ncsurobotics/DEPRECATED-SW8-Electrical/README.md

# Seawolf 8 Project Repository
This repo contains the design files and other relevant information about the load balancing board for SW8.
