ncsurobotics/DEPRECATED-SW8-Electrical/projects/meb/MEB.pdf

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
ENABLE

KILL_3V3

SCL

SDA

MSP430
Microcontroller.SchDoc

GND

+3.3V

SSR_IN
ENABLE

Designator
Power Control.SchDoc

GATE
KILL_RAW

KILL_3V3

Designator
ThrusterControl.SchDoc

1
2
3
4

P12

22-27-2041

Drain
Gate
Source

P11

22-27-2031

GND

D11

1N4007-T

VCC

2
1

P13

22-27-2021

R11
4.7k

GND

Killswitch external input

3

2 1

4

6 5

8 7 10 9
P14
HTSS-105-01-T-DV

GND

5V Power Bank for fans, etc

External connection to IXTN660N04T4

VCC FLYBACK
GATE

KILL_RAW

+5V

SDA
SCL

I2C Header

2
1

P15

22-27-2021

SSR_IN

Relay Coil Input

BATT

Designator
PowerConditioning.SchDoc

2

1

P16

B2B-XH-A(LF)(SN)

BATT

GND

D D

C C

B B

A A

Title

Size | Number | | Revision
A
Date: | 9/22/2019 | Sheet | of
File: | C:\Users\..\Microcontroller.SchDoc | Drawn By:

P1.4
P1.3

P1.5

P1.7

P1.6

RST

NC

P3.0

P1.2

GND

P22

61301011121

P4.2

Vcc

P2.6
P2.5
P4.3
P2.4
P2.2
P3.4
P3.5
P3.6

P21

61301011121

+3.3V | GND

VCC

GND

R21
8.2k

R22
2k
V_SENSE | KILL_3V³
KILL_3V3 | ENABLE

+3.3V

R23
4.7k
R24

4.7k SCL SDA

SDA
SCL

D D

C C

B B

A A

Title

Size | Number | Revision
File: | C:\Users\..\Power Control.SchDoc | Drawn By:

PMV16XNR

# Q31 SSR_IN

GND | 1

2

3

4

FSM2JSMA

SW31

GND

R32
1k

R33

# 100 ENABLE

1

2

3

4

FSM2JSMA

SW32

GND

SSR_ENABLE

GND

3
2
1

P31

22-27-2031

SSR_IN

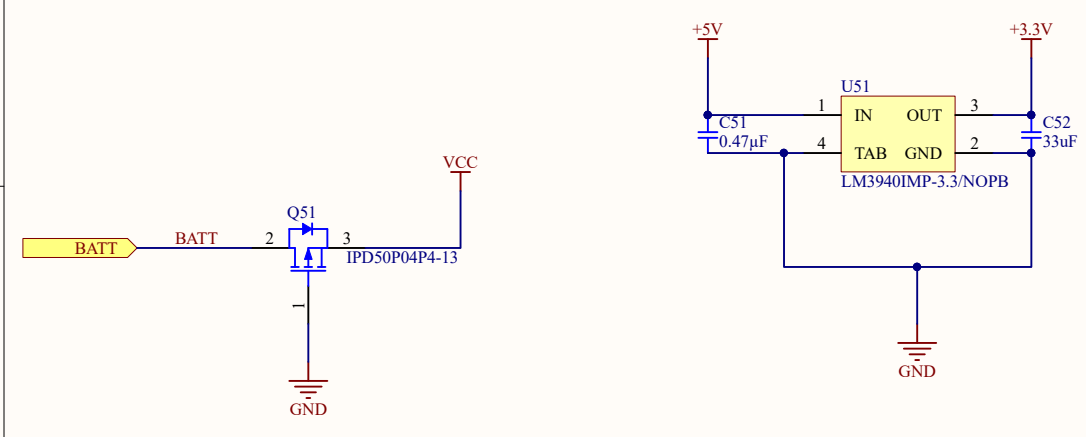
[picture p1: page 4]
Title; Size; Number; Revision; File:; C:\Users\..\PowerConditioning.SchDoc; Drawn By:; VCC; IPD50P04P4-13; GND; BATT; OUT; 2 TAB 4; LM3940IMP-3.3/NOPB

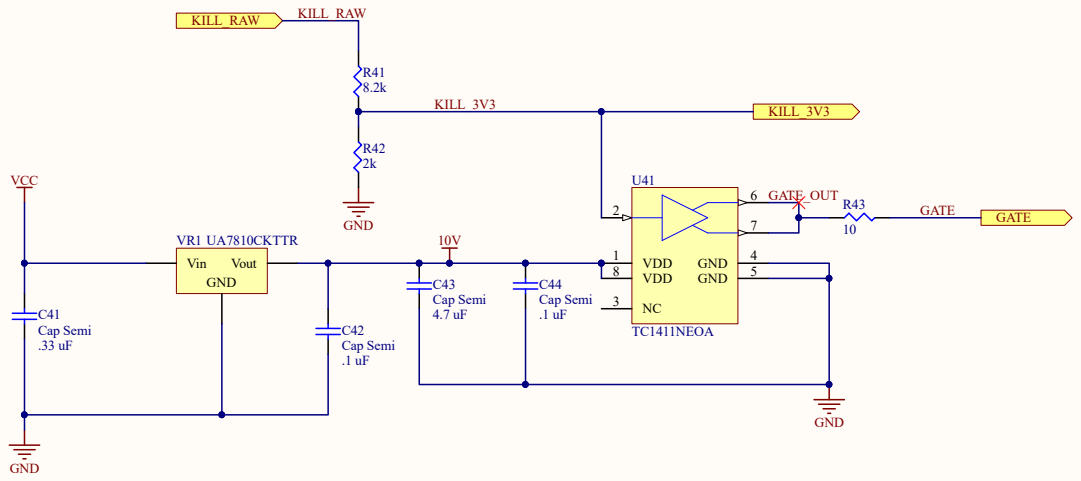
[picture p2: page 5]
