ncsurobotics/DEPRECATED-SW8-Electrical/projects/new_member_Altium_project/Project Outputs for New Member Design Project/New Member Design Project.pdf

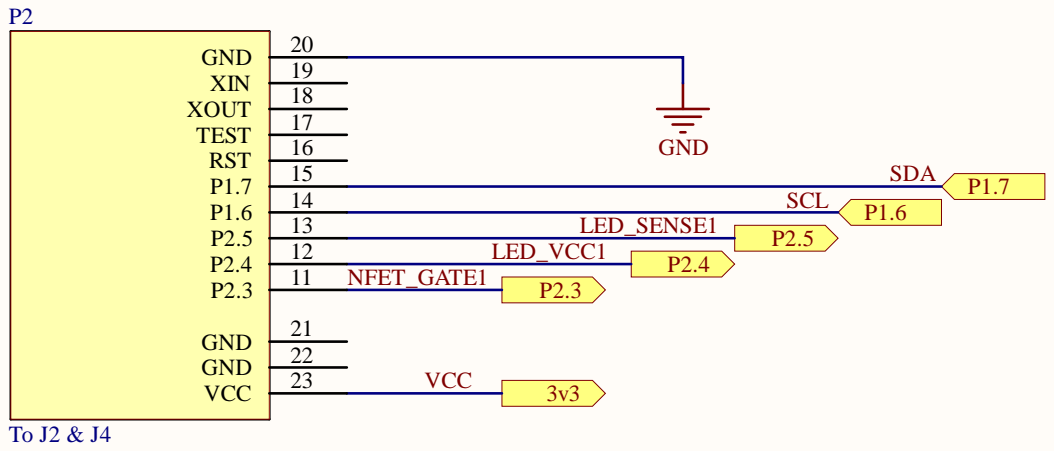
[picture p3: page 1]

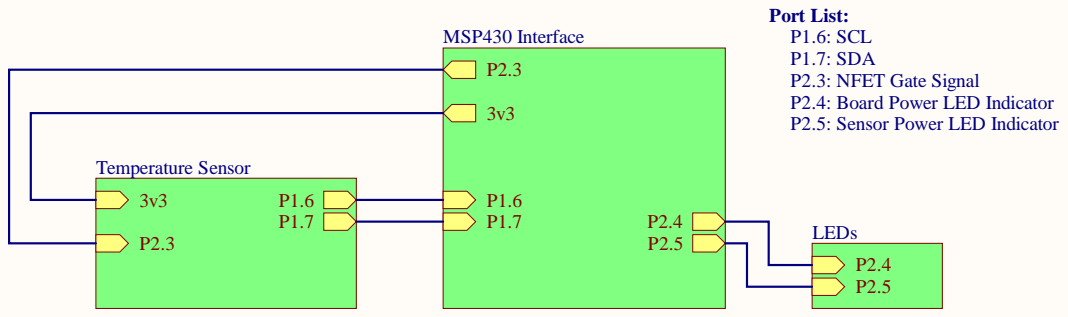
[picture p4: page 2]

Port List:
P1.6: SCL
P1.7: SDA
P2.3: NFET Gate Signal
P2.4: Board Power LED Indicator
P2.5: Sensor Power LED Indicator

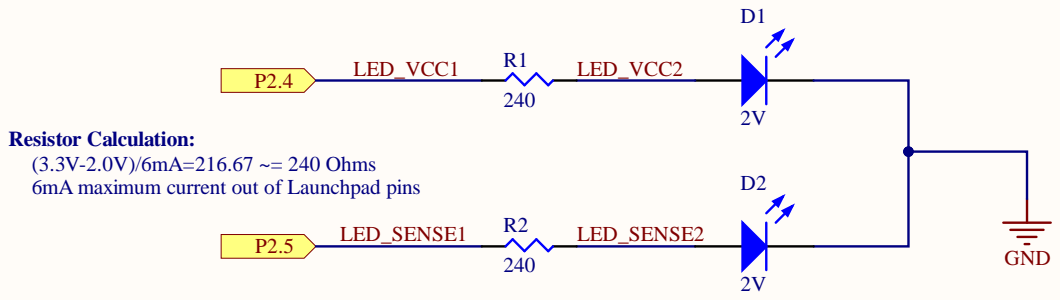
[picture p5: page 3]

Resistor Calculation:
(3.3V-2.0V)/6mA=216.67 ~= 240 Ohms
6mA maximum current out of Launchpad pins

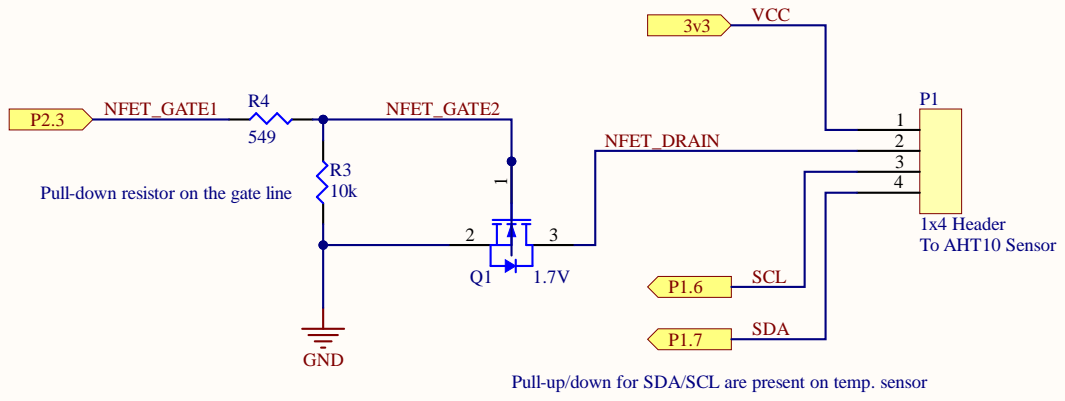
[picture p6: page 4]

Pull-down resistor on the gate line

Pull-up/down for SDA/SCL are present on temp. sensor

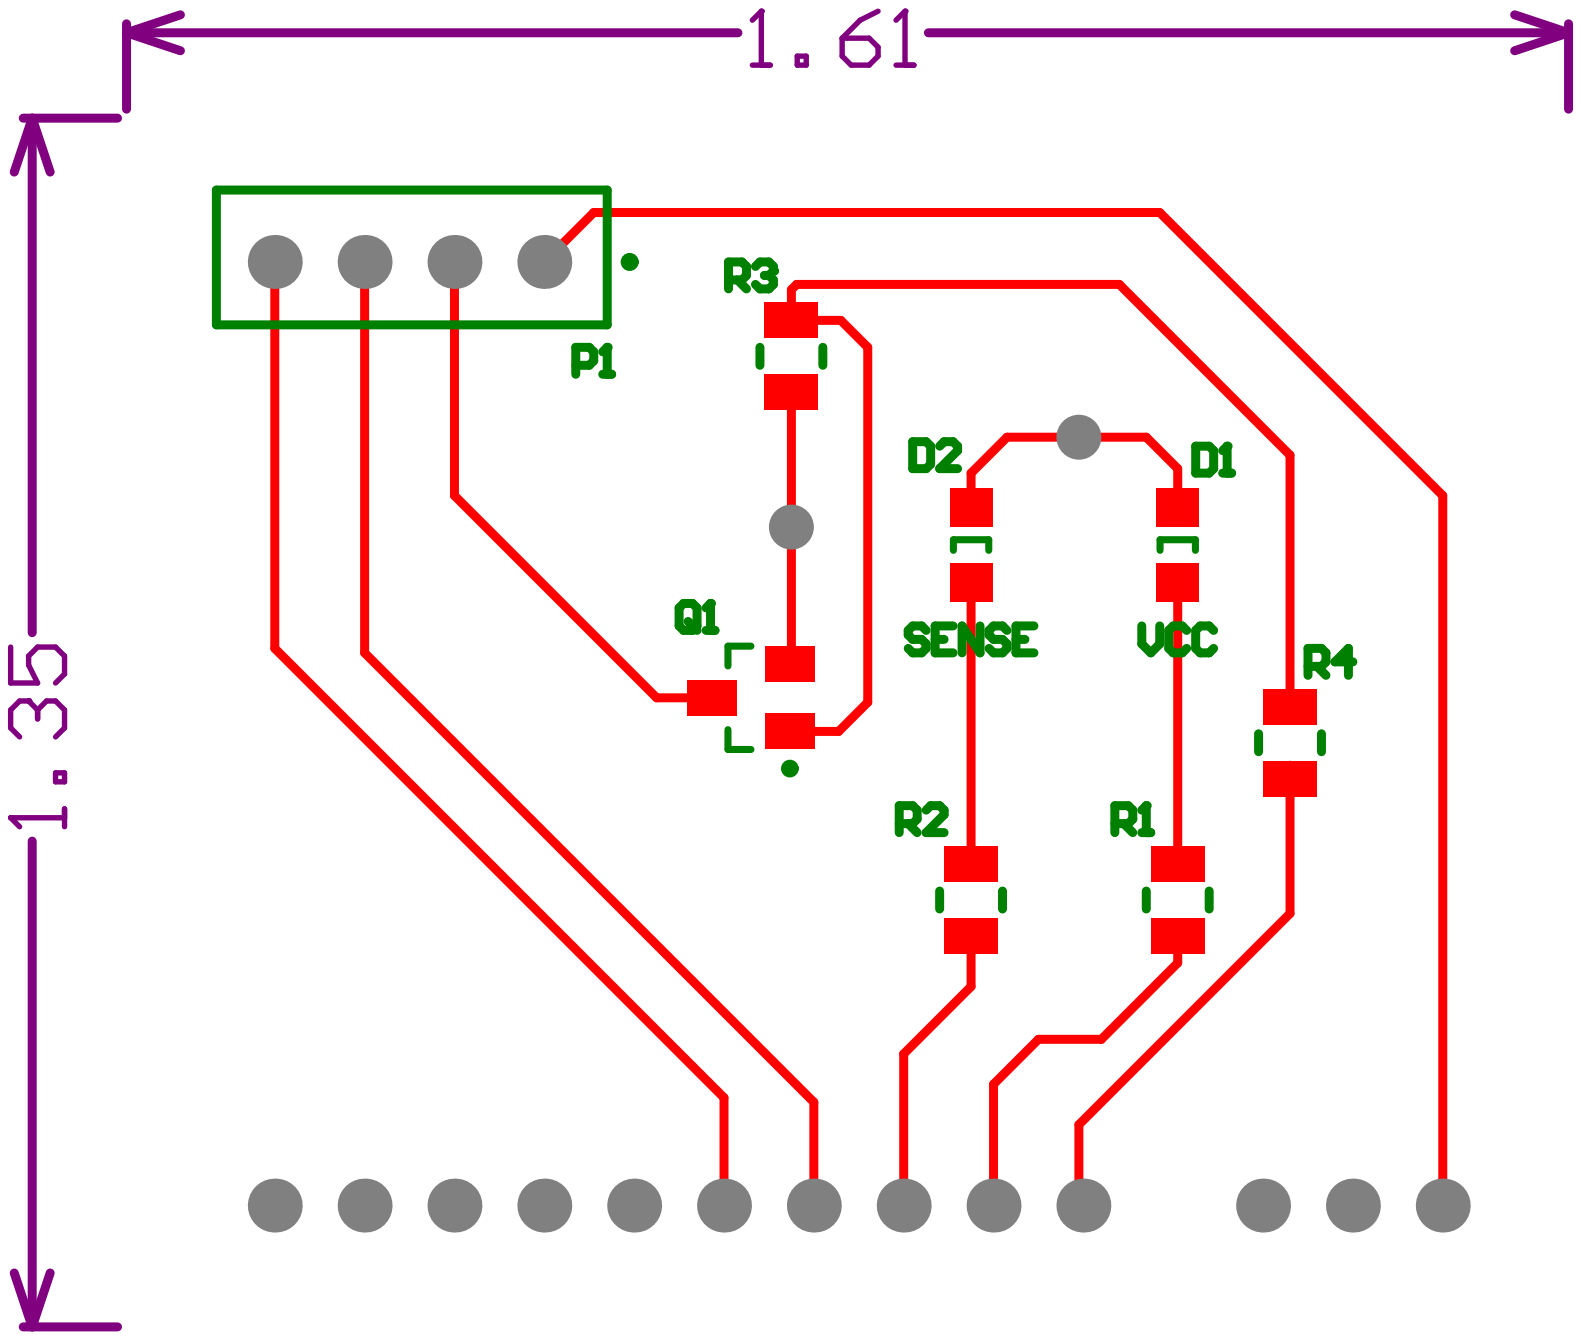
[picture p7: page 5]

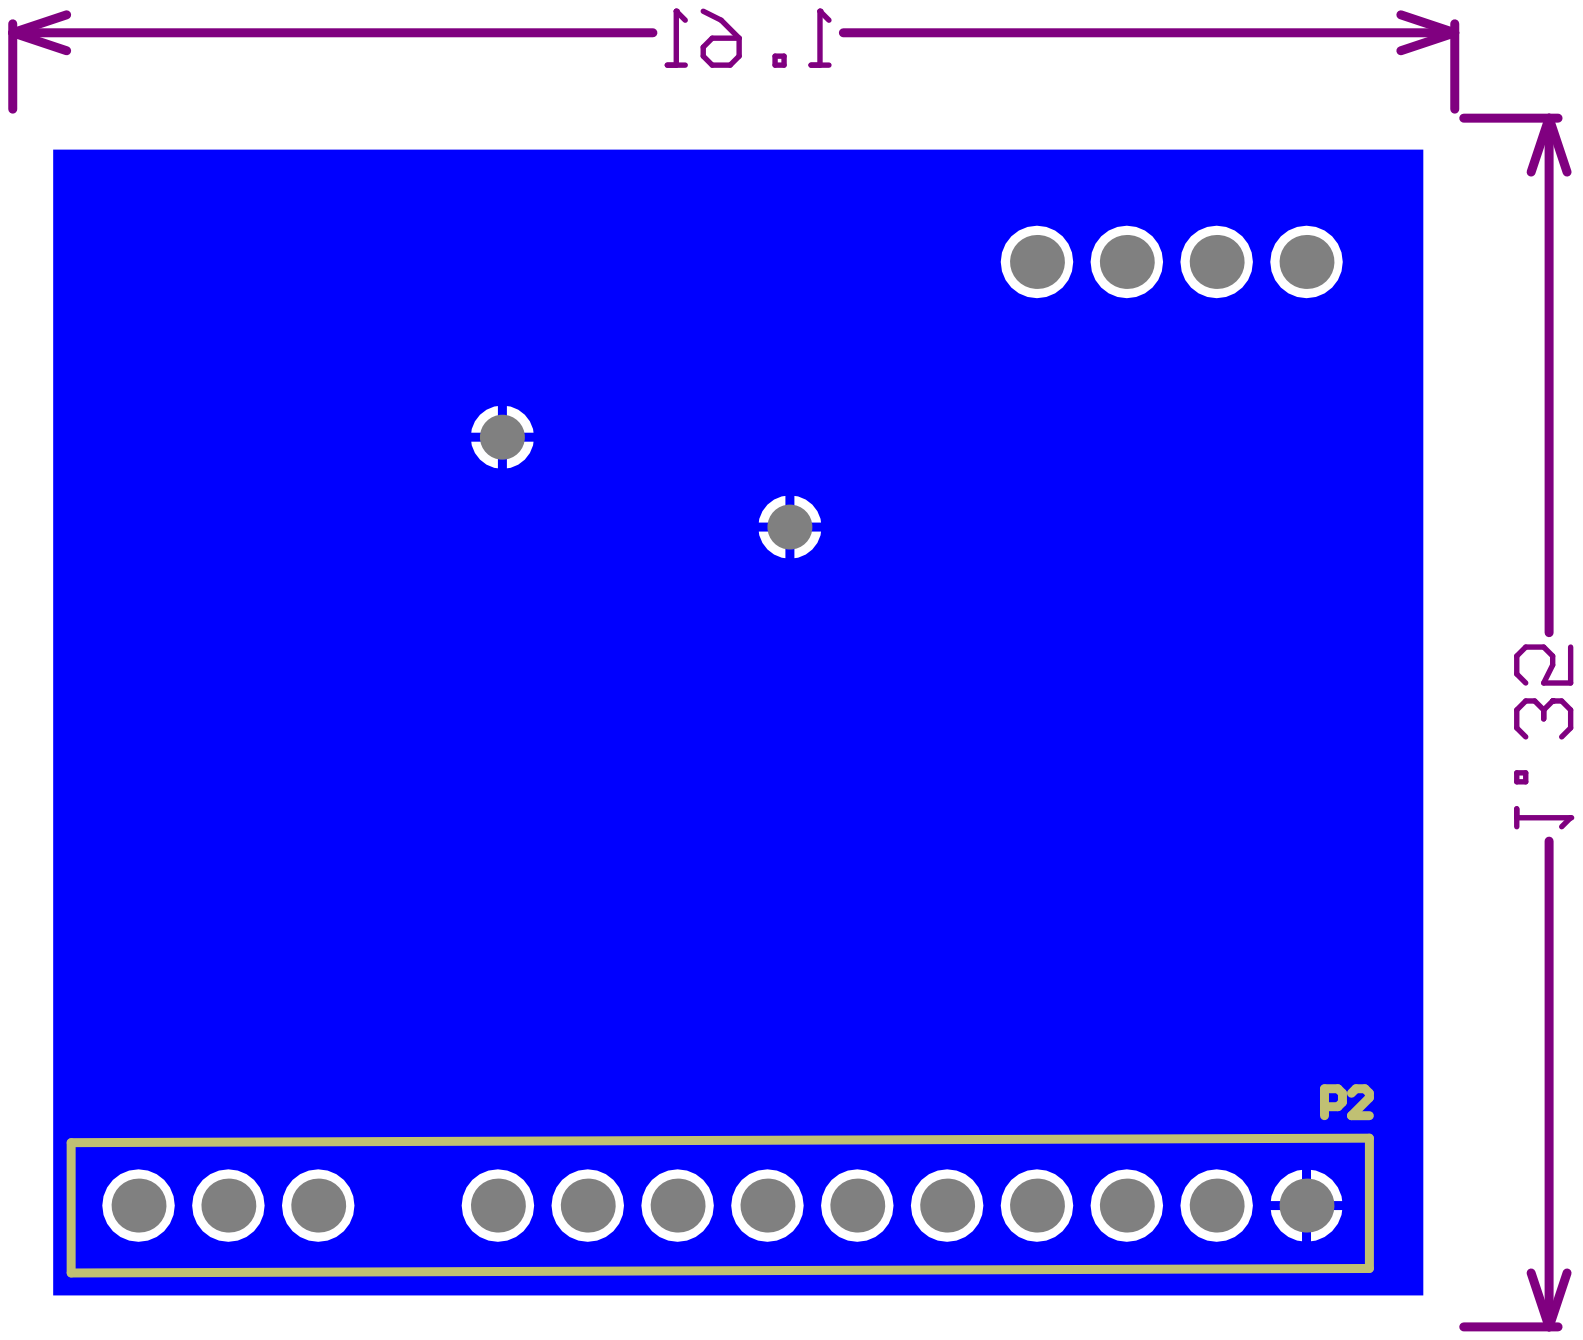
[picture p8: page 6]
