ncsurobotics/DEPRECATED-SW8-Electrical/(list of files, drawings)

Other design files:
projects/load_balancing_board/6 Port plug in terminal.PcbLib
projects/load_balancing_board/6 Port plug in terminal.SchLib
projects/load_balancing_board/IntroProject.PrjPcb
projects/load_balancing_board/Load Ballancing Circuit PCB.PcbDoc
projects/load_balancing_board/Load Ballancing Circuit.SchDoc
projects/load_balancing_board/Resistor.PcbLib
projects/load_balancing_board/Sheet1.SchDoc
projects/load_balancing_board/small capacitor.PcbLib
projects/load_balancing_board/Zenor Diode for Reverse Voltage Controller.SchLib
projects/load_balancing_board/Zenor Diode.PcbLib
projects/meb/5V Regulator Schematic.schdoc
projects/meb/Launchpad.PcbLib
projects/meb/MainBoard.SchDoc
projects/meb/MEB.PrjPcb
projects/meb/Microcontroller.SchDoc
projects/meb/MSP Launchpad.PcbLib
projects/meb/MSP Launchpad.SchLib
projects/meb/PCB2.PcbDoc
projects/meb/Power Control.SchDoc
projects/meb/ThrusterControl.SchDoc
projects/new_member_Altium_project/Launchpad Header.SchDoc
projects/new_member_Altium_project/Launchpad.SchDoc
projects/new_member_Altium_project/New Member Design Project.PrjPcb
projects/new_member_Altium_project/New Member Design Schematic.SchDoc
projects/new_member_Altium_project/NMP Schematic.SchDoc
projects/new_member_Altium_project/PCB.PcbDoc
projects/new_member_Altium_project/Status LEDs.SchDoc
projects/new_member_Altium_project/Temperature Sensor.SchDoc
projects/optoisolator_board/1x8 Male Header.SCHLIB
projects/optoisolator_board/3x8 Female Header.SCHLIB
projects/optoisolator_board/3x8 Male Header.SchLib
projects/optoisolator_board/FemaleHeader.SchDoc
projects/optoisolator_board/Header PCB Library.PcbLib
projects/optoisolator_board/MaleHeader.SchDoc
projects/optoisolator_board/Master Schematic.SchDoc
projects/optoisolator_board/OptoBoard.SchDoc
projects/optoisolator_board/Optoisolator-Board.PrjPcb
projects/optoisolator_board/Optoisolator-Board_1.SCHLIB
projects/optoisolator_board/OptoPCB.PcbDoc
