ncsurobotics/DEPRECATED-SW8-Electrical/(commit log)

2020-03-31 Added regulator caps
    [1x8 Male Header.SCHLIB, 3x8 Female Header.SCHLIB, 3x8 Male Header.SchLib, FemaleHeader.SchDoc, Header PCB Library.PcbLib, MaleHeader.SchDoc, OptoBoard.SchDoc, OptoPCB.PcbDoc]
2020-09-13 Add files via upload
    Initial Commit
    [Launchpad.SchLib, New Member Design Project.PrjPcb, Sheet1.SchDoc, Sheet2.SchDoc, Sheet3.SchDoc]
2020-09-19 Cleaned up appearance and added large overall schematic
    [Launchpad.SchDoc, Launchpad.SchLib, New Member Design Project.PrjPcb, New Member Design Schematic.SchDoc, Sheet1.SchDoc, Sheet2.SchDoc, Sheet3.SchDoc, Status LEDs.SchDoc]
2020-09-21 added Launchpad PCB file
    [Launchpad.SchLib, New Member Design Project.PrjPcb]
2020-09-22 Added Launchpad PCB and fixed Net errors
    [New Member Design Schematic.SchDoc]
2020-09-28 launchpad added
    [Launchpad.SchDoc, Launchpad_PCB.PcbLib]
2020-09-29 test 4
    [New Member Design Schematic.SchDoc]
2020-09-29 Schematic updated
    [New Member Design Schematic.SchDoc]
2020-10-05 PCB made
    [New Member Design Project.PrjPcb, PCB1.PcbDoc]
2020-10-07 PCB finalized
    [New Member Design Project.PrjPcb, PCB1.PcbDoc]
2020-10-07 shifted temp sense up in PCB
    [PCB1.PcbDoc]
2020-10-12 new pin layout and mounting for launchpad
    [4 pin header pcb.PcbLib, 4 pin header.SchLib, Launchpad.SchDoc, Launchpad.SchLib, Launchpad_PCB.PcbLib, New Member Design Project.PrjPcb, New Member Design Schematic.SchDoc, PCB1.PcbDoc]
2020-10-13 oriented launchpad properly
    [PCB1.PcbDoc]
2020-10-13 removed pullup resistors and added FET pulldown and gate resistors
    [Launchpad.SchDoc, PCB1.PcbDoc, Temperature Sensor.SchDoc]
2020-10-14 nets relabeled and errors fixed
    [Launchpad.SchDoc, PCB1.PcbDoc, Status LEDs.SchDoc, Temperature Sensor.SchDoc]
2020-10-16 GND pour added
    [PCB1.PcbDoc, Temperature Sensor.SchDoc]
2020-10-16 Board size adjusted
    [PCB1.PcbDoc]
2020-10-29 Removed planes and repoured
    [PCB1.PcbDoc]
2020-10-29 Moved pour to bottom layer
    [PCB1.PcbDoc]
2020-11-01 Resized board
    [OptoPCB.PcbDoc]
2020-11-01 Added border to PCB
    [OptoPCB.PcbDoc]
2020-11-04 Fixed PCB bottom left corner, added .gitignore
    [PCB1.PcbDoc]
2021-02-25 fixed silkscreens and created BOM
    [OptoBoard.SchDoc, OptoPCB.PcbDoc, Optoisolator-Board.xlsx]
2021-03-01 updated schematic nets, components, layout
    [Launchpad Header.SchDoc, Launchpad.SchDoc, Launchpad.SchLib, Launchpad_PCB.PcbLib, NMP Schematic.SchDoc, New Member Design Project.PrjPcb, New Member Design Schematic.SchDoc, PCB.PcbDoc]
2021-03-01 fixed component parameters, generated BOM
    [Launchpad Header.SchDoc, PCB.PcbDoc, Status LEDs.SchDoc, Temperature Sensor.SchDoc]
2021-03-02 updated board shape, added dimensions, requested DFM check
    [New Member Design Project.PrjPcb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]
2021-03-07 Updated Libraries
    [4 pin header pcb.PcbLib, 4 pin header.SchLib, Launchpad Header.SchDoc, Launchpad.SchLib, Launchpad_PCB.PcbLib, NMP Schematic.SchDoc, New Member Design Project.PrjPcb, PCB.PcbDoc]
2021-03-11 updated component parameters and BOM
    [Launchpad Header.SchDoc, NMP Schematic.SchDoc, New Member Design Project.PrjPcb, PCB.PcbDoc, Status LEDs.SchDoc, Temperature Sensor.SchDoc]
2021-03-12 added schematic and layout pdf
    [New Member Design Project.PrjPcb]
2021-03-13 updated msp430 custom mating pins description
    [Launchpad Header.SchDoc, New Member Design Project.PrjPcb, PCB.PcbDoc]
2021-03-14 cleaned up layout traces
    [Launchpad Header.SchDoc, New Member Design Project.PrjPcb, PCB.PcbDoc, Status LEDs.SchDoc, Temperature Sensor.SchDoc]
2021-03-16 generated BOM, fixed designators in schematics, fixed I/O direction of ports and pins
    [3x8 Female Header.SCHLIB, 3x8 Male Header.SchLib, FemaleHeader.SchDoc, MaleHeader.SchDoc, Master Schematic.SchDoc, OptoBoard.SchDoc, OptoPCB.PcbDoc, Optoisolator-Board.PrjPcb]
2021-03-19 Swapped caps, rerouted to center of pads, corrected BOM and net labels
    [FemaleHeader.SchDoc, MaleHeader.SchDoc, OptoBoard.SchDoc, OptoPCB.PcbDoc]
2021-03-20 fixed a few traces to enter pads in their center
    [OptoPCB.PcbDoc]
2021-03-20 added logos, updated status LED notes
    [New Member Design Project.PrjPcb, PCB.PcbDoc, Status LEDs.SchDoc]
2021-03-29 changed LED to regulator output
    [OptoBoard.SchDoc, OptoPCB.PcbDoc]
2021-03-31 Fixed resistor values
    [OptoBoard.SchDoc, OptoPCB.PcbDoc]
2021-04-03 aligned R2s
    [OptoPCB.PcbDoc]
2021-04-08 Rerouted GND traces directly to vias
    [OptoPCB.PcbDoc]
2021-04-14 straightened traces and added rationalization notes on schematic
    [OptoBoard.SchDoc, OptoPCB.PcbDoc]
2021-05-29 Enlargened annular rings of 3x8 female header
    [FemaleHeader.SchDoc, OptoPCB.PcbDoc]
2021-05-29 idek man it's just different
    [Optoisolator-Board.PrjPcb]
2021-06-03 Swapped 5VR for an SMD package
    [OptoBoard.SchDoc, OptoPCB.PcbDoc, Optoisolator-Board.PrjPcb]
2021-07-10 Moving merged files
    [1x8 Male Header.SCHLIB, 3x8 Female Header.SCHLIB, 3x8 Male Header.SchLib, FemaleHeader.SchDoc, Header PCB Library.PcbLib, MaleHeader.SchDoc, Master Schematic.SchDoc, OptoBoard.SchDoc]
